go4retro/VIC-MIDI/doc/cFxUoKs.png

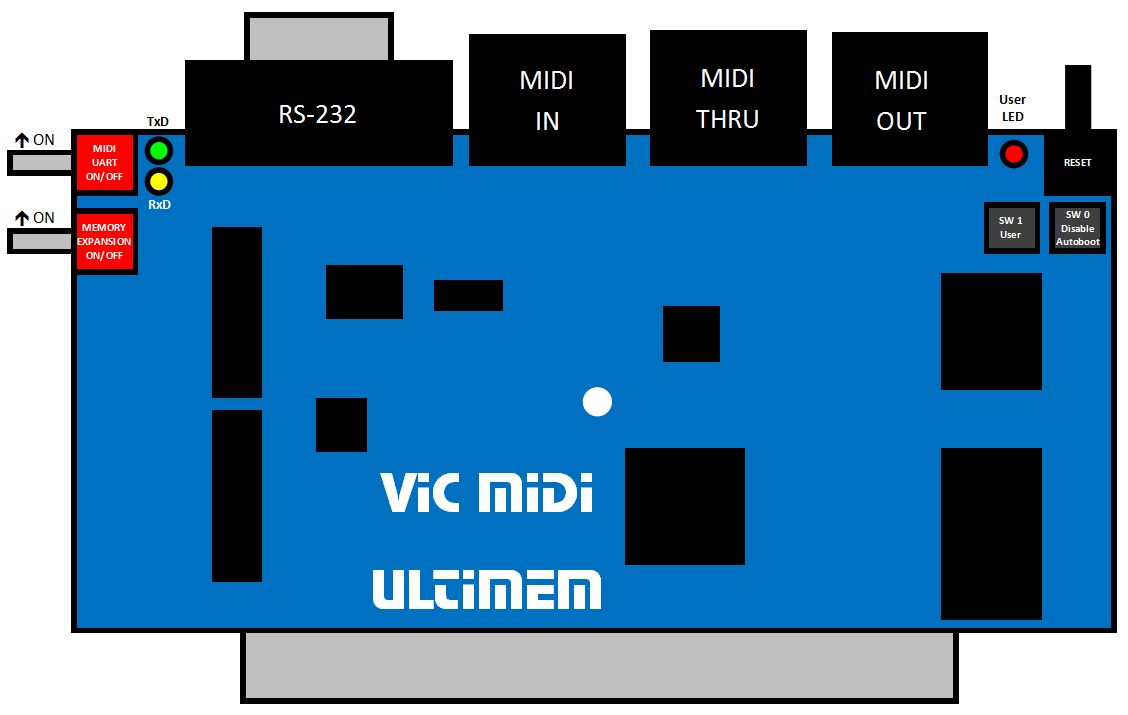
doc/cFxUoKs.png
