go4retro/VIC-MIDI/pcb/VIC-MIDI Final (no pour).png

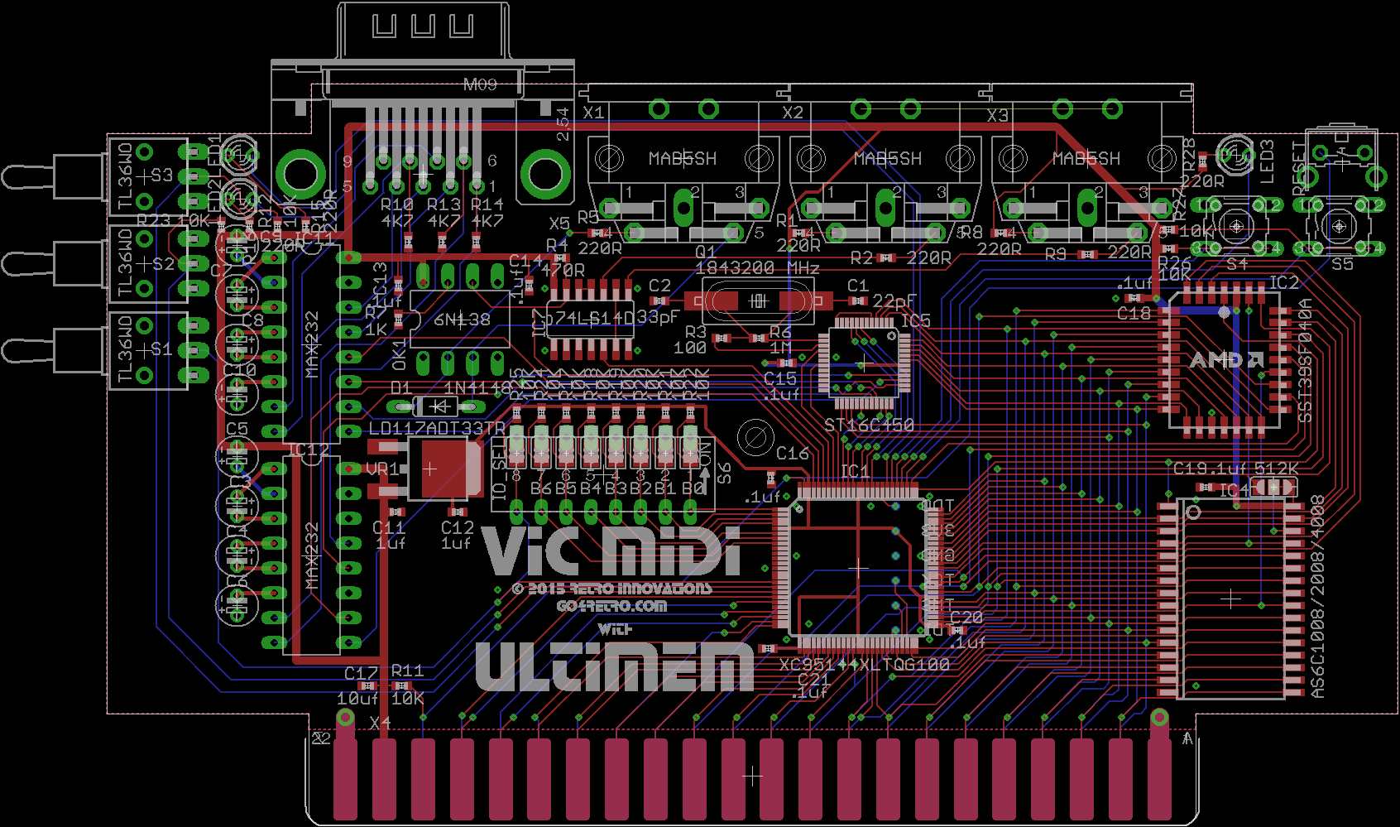
pcb/VIC-MIDI Final (no pour).png
