go4retro/VIC-MIDI/pcb/VIC-MIDI Schematic.png

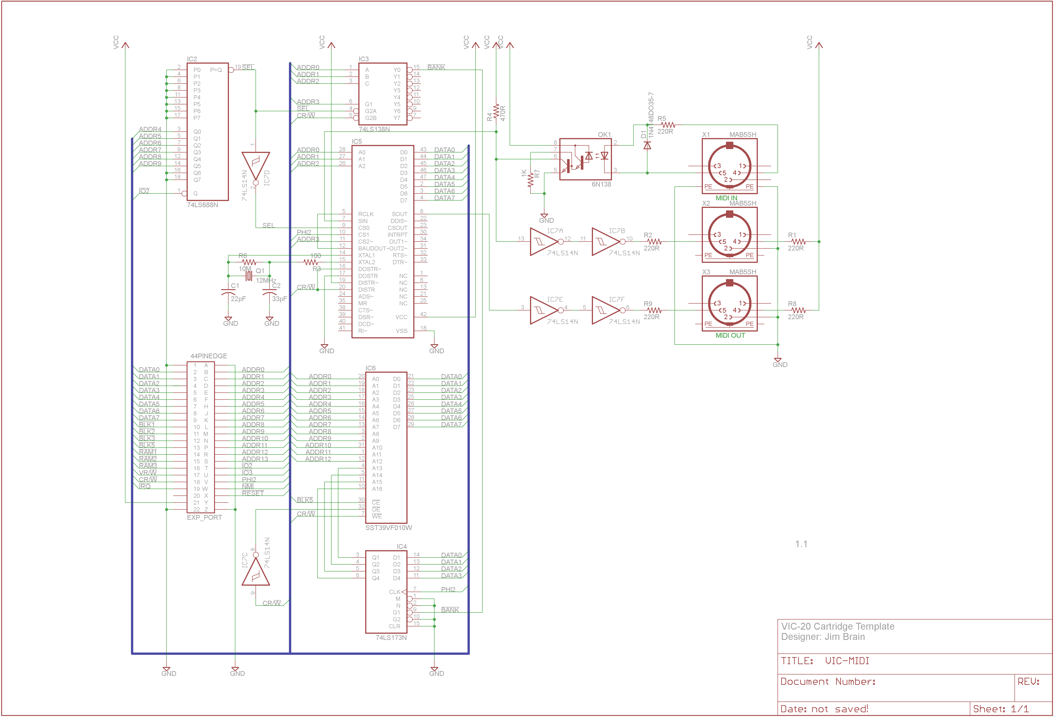
pcb/VIC-MIDI Schematic.png
