go4retro/VIC-MIDI/pcb/VIC-MIDI v0.9 Schematic.png

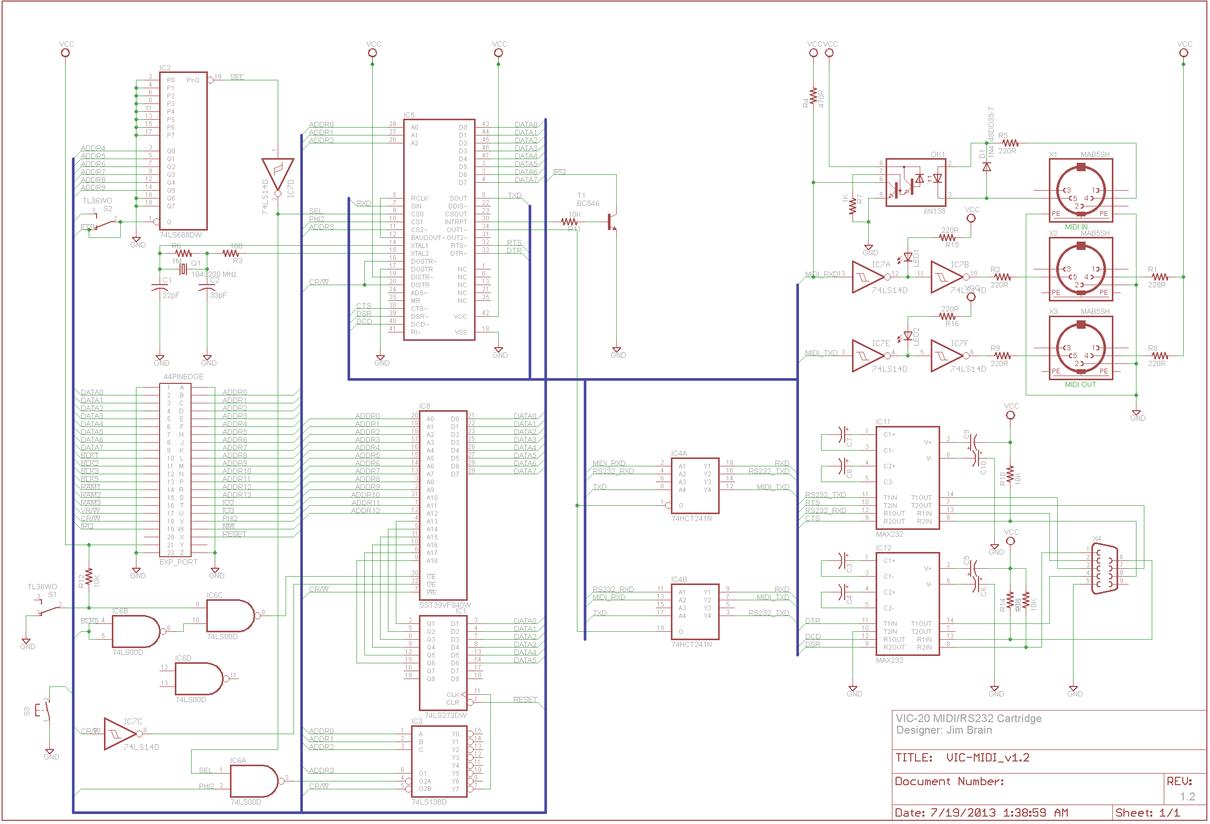
pcb/VIC-MIDI v0.9 Schematic.png
