go4retro/VIC-MIDI/pcb/VIC-MIDI_v1.0b_BOM_np.xlsx

 | Legend | Quantity | Value | Part Number
UltiMem
 | VR1 | 1 | 3.3V LDO VR | LD117ADT33TR
 | IC2 | 1 | 512kBx8 ROM | AM29F040B
 | IC1 | 1 | XC95144XLTQ100 | XC95144XL-TQ100
 | IC3 | 1 | 128kBx8 RAM | KM68100BLG-7L
 | C11,C12 | 1 | 1uf | C-USC0402
 | C17 | 2 | 10uf | C-USC0402
 | C13,C14,C15,C16,C18,C19,C20,C21 | 8 | .1uf | C-USC0402
 | RESET | 1 |  | 31-XX
 | S1,S2 | 2 | TL36WO | TL36WO
 | S4,S5 | 2
 | IC5 | 1 | ST16C450 | XR-16C450Q
 | Q1 | 1 | 1843200 MHz | CRYSTALHC49UP
 | LED1 | 1 | red | LED3MM
 | LED2 | 1 | yellow | LED3MM
 | LED3 | 1 | green | LED3MM
 | C1 | 1 | 22pF | C-USC0402
 | C2 | 1 | 33pF | C-USC0402
 | R3 | 1 | 100 | R-US_R0402
 | R6 | 1 | 1M | R-US_R0402
 | R15,R16,R28 | 3 | 220R | R-US_R0402
 | R11,R12,R17-R25 | 11 | 10K | R-US_R0402
MIDI
 | D1 | 1 | 1N4148 | 1N4148DO35-7
 | IC7 | 1 | 74HCT14 | 74HCT14
 | OK1 | 1 | 6N138 | 6N138
 | X1-X3 | 3 | DIN5 | SDS-50J (http://www.digikey.com/product-detail/en/SDS-50J/CP-2350-ND/97033)
 | R1,R2,R5,R8,R9 | 5 | 220R | R-US_R0402
 | R4 | 1 | 470R | R-US_R0402
 | R7 | 1 | 1K | R-US_R0402
RS232
 | IC11,IC12 | 2 | MAX232 | MAX232
 | C3-C10 | 8 | 1uF | CPOL-USE2-4
 | X4 | 1 | DE-9 M | 1-1634580-2 (http://www.digikey.com/product-detail/en/1-1634580-2/A109020-ND/4031352)
 | R10,R13,R14 | 3 | 4K7 | R-US_R0402
