go4retro/VIC-MIDI/pcb/VIC-MIDI_v1.0b.brd

## EAGLE design pcb/VIC-MIDI_v1.0b.brd (2018-05-06)

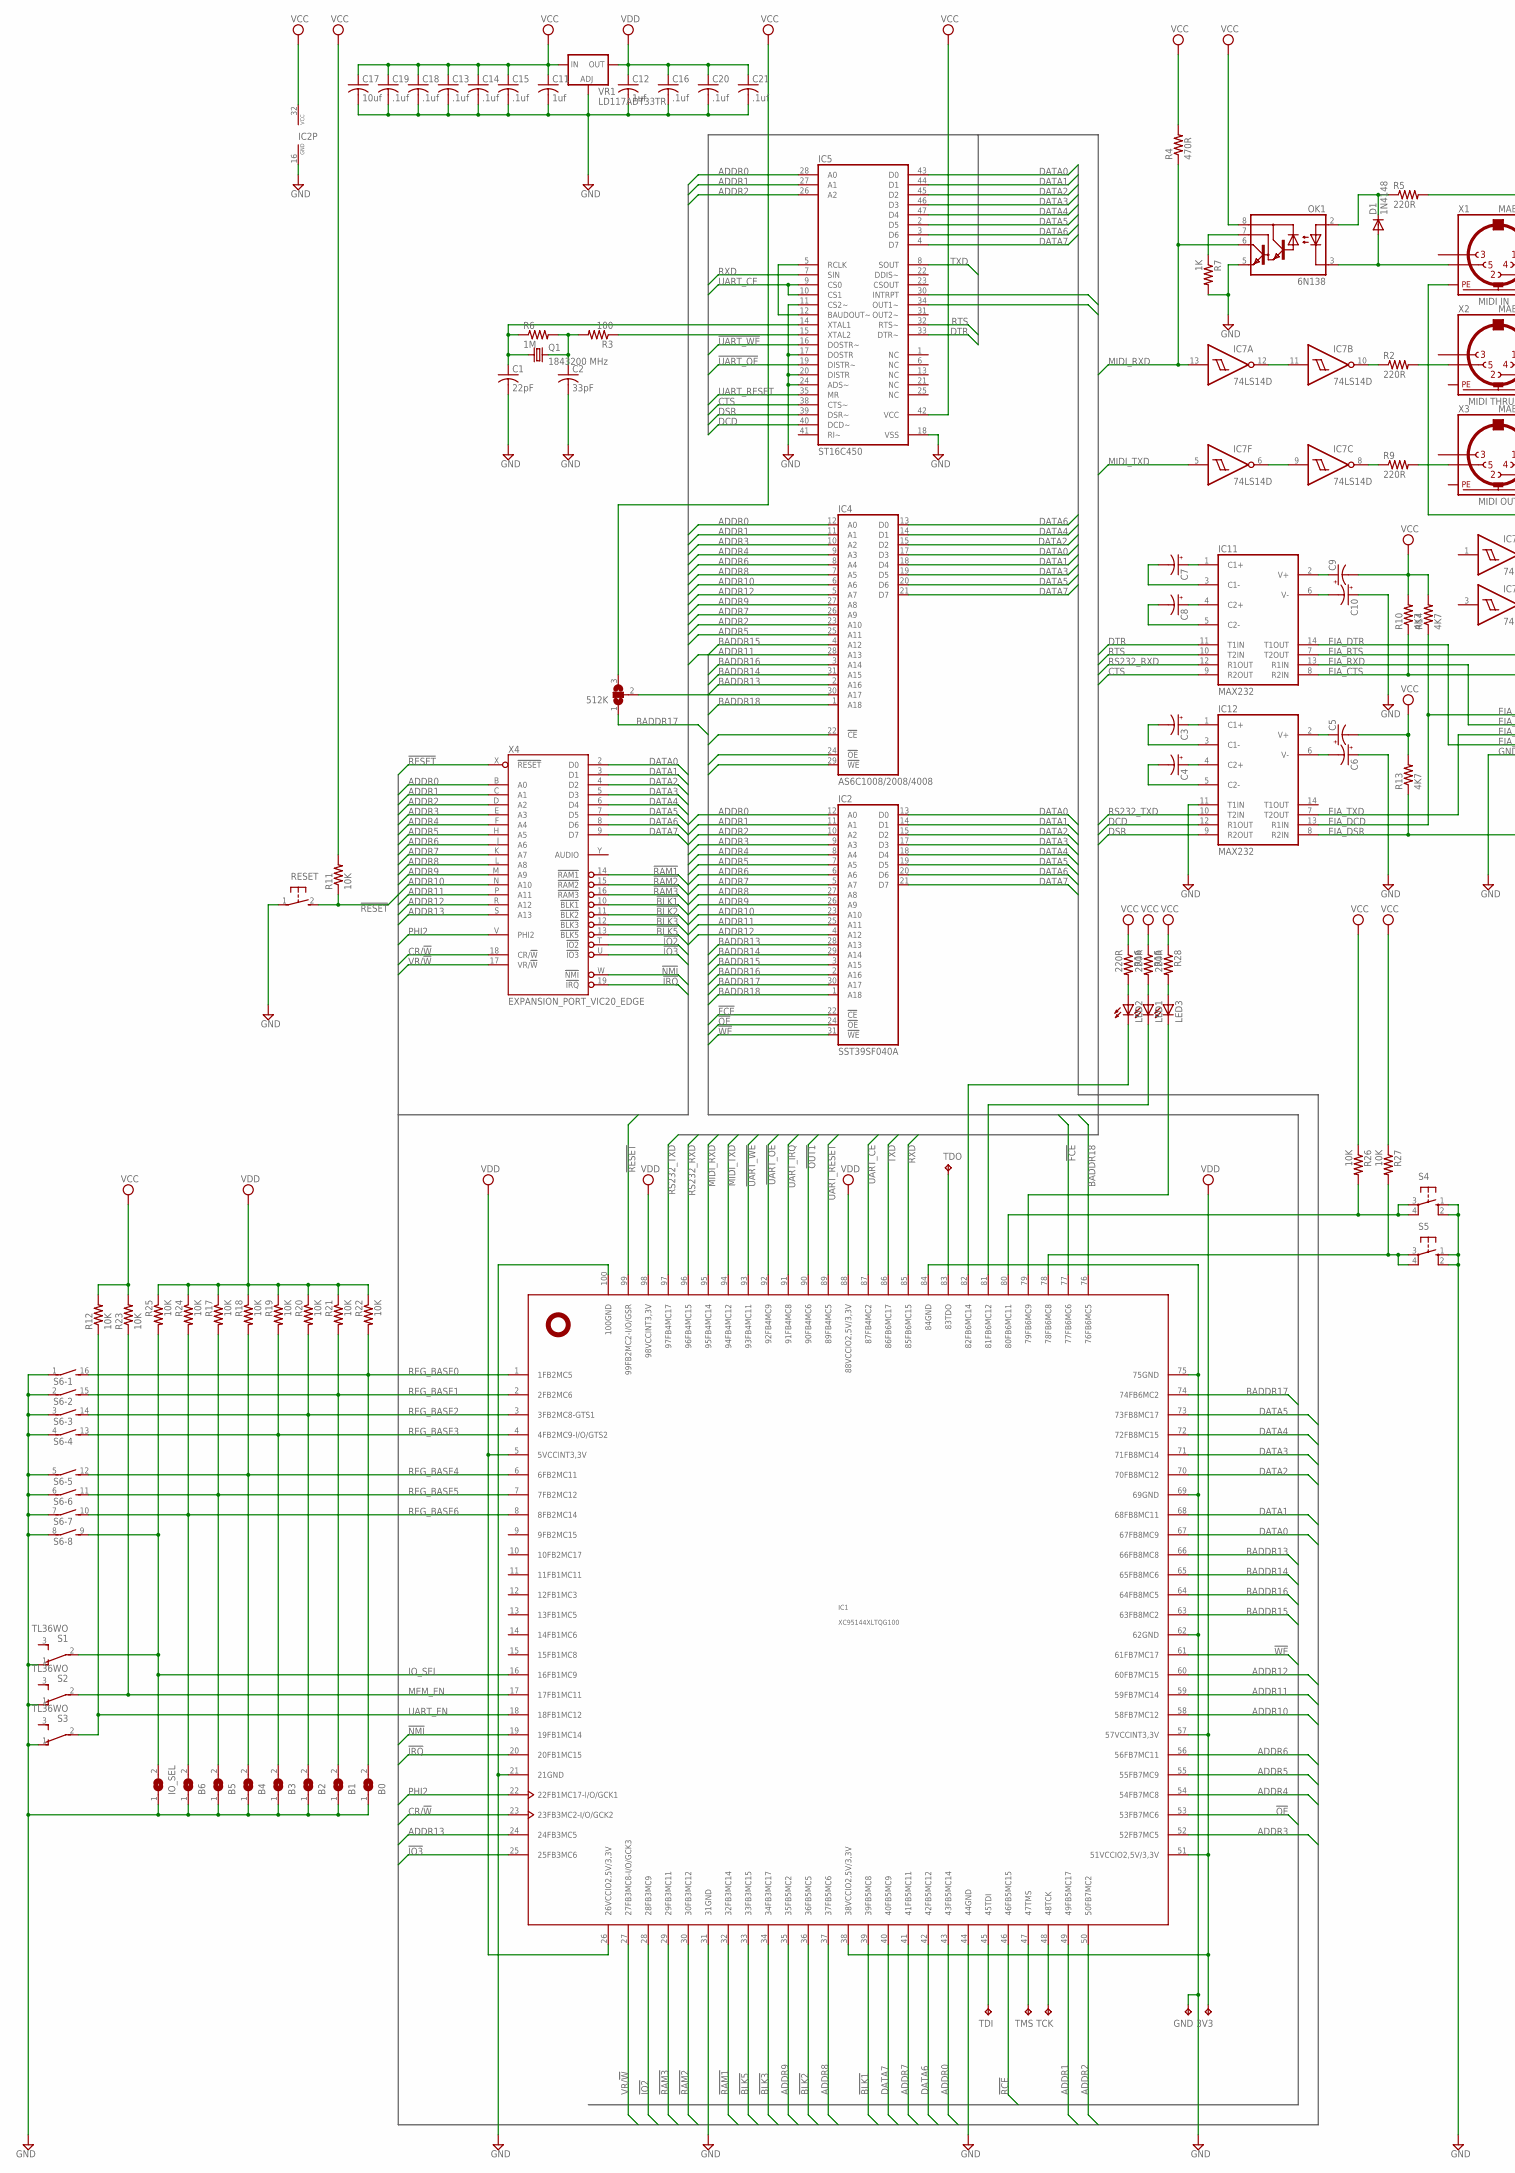
[picture p8: schematic VIC-MIDI_v1.0b.sch, part in row 1, column 1]

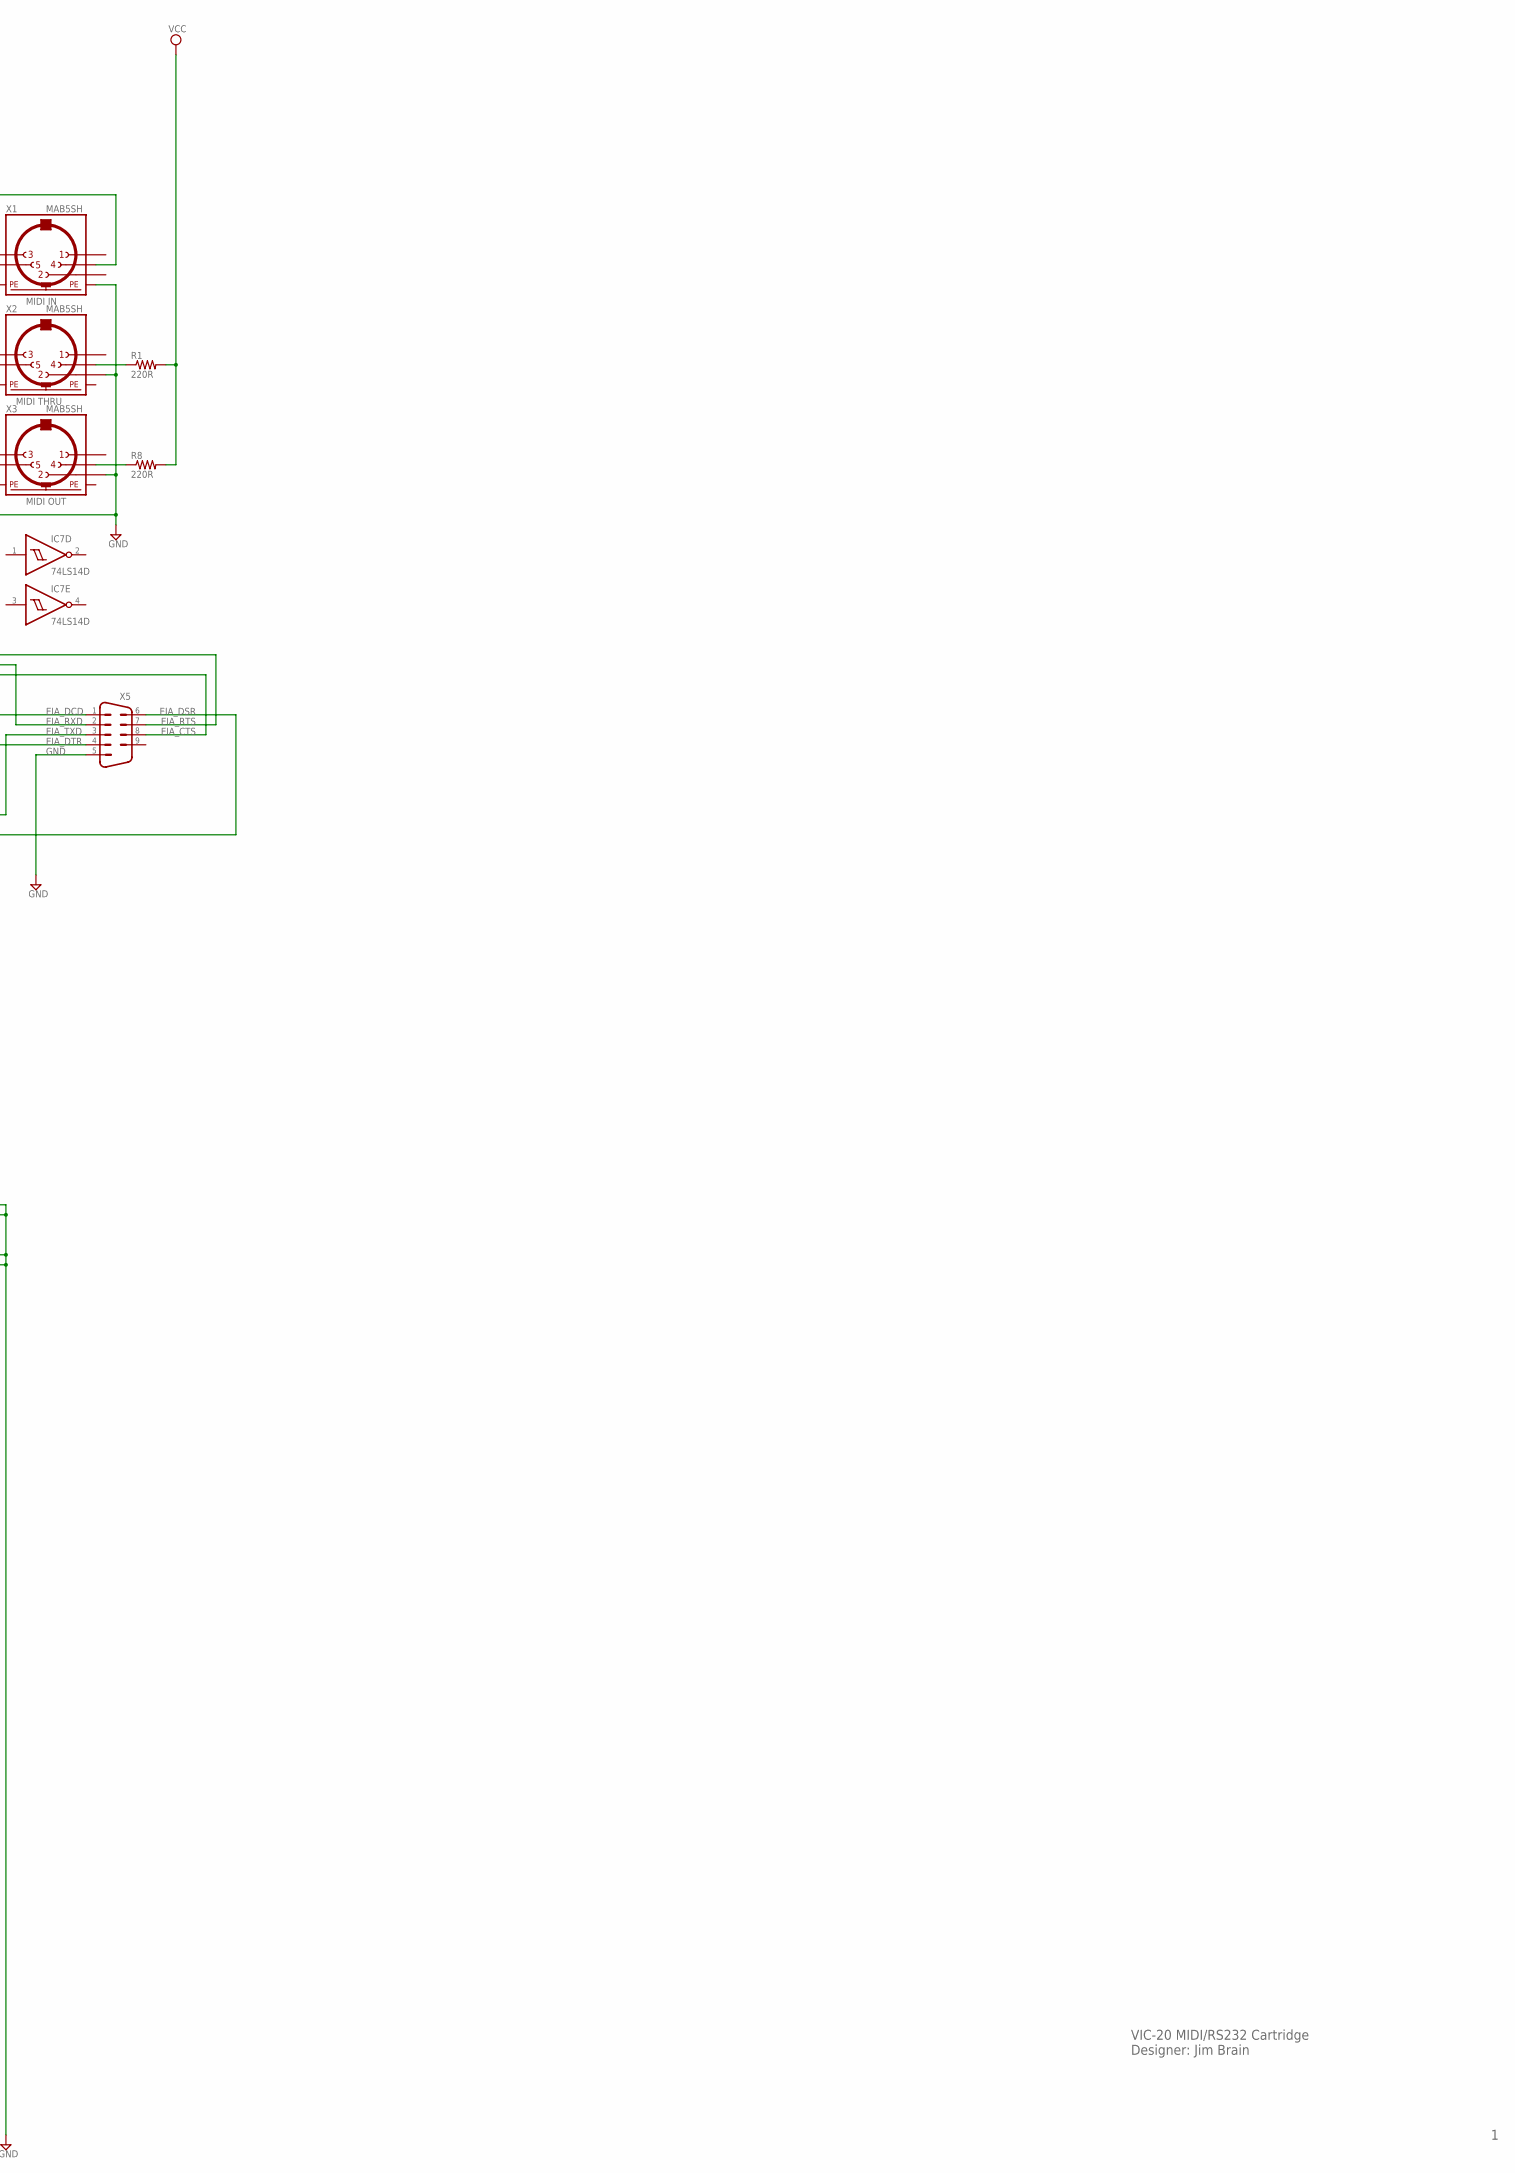
[picture p9: schematic VIC-MIDI_v1.0b.sch, part in row 1, column 2]

Parts:
3V3: TPTP08R; TP08R
512K: SJ2W; SJ_2
B0, B1, B2, B3, B4, B5, B6: SJ
C1: 22pF; C0402
C2: 33pF; C0402
C3, C4, C5, C6, C7, C8, C9, C10: CPOL-USE2-4; E2-4
C11, C12: 1uf; C0402
C13, C14, C15, C16, C18, C19, C20, C21: .1uf; C0402
C17: 10uf; C0402
D1: 1N4148; DO35-7
GND: TPTP08R; TP08R
IC1: XC95144XLTQG100; TQFP100
IC2: SST39SF040A; PLCC32R
IC4: AS6C1008/2008/4008; SOP32L
IC5: ST16C450; TQFP48
IC7: 74LS14D; SO14
IC11, IC12: MAX232; DIL16
IO_SEL: SJ
LED1, LED2, LED3: LED3MM
OK1: 6N138; DIL08
Q1: 1843200 MHz; HC49UP
R1, R2, R5, R8, R9, R15, R16, R28: 220R; R0402
R3: 100; R0402
R4: 470R; R0402
R6: 1M; R0402
R7: 1K; R0402
R10, R13, R14: 4K7; R0402
R11, R12, R17, R18, R19, R20, R21, R22, R23, R24, R25, R26, R27: 10K; R0402
RESET: 31-XX; B3F-31XX
S1, S2, S3: TL36WO; TL3XWO
S4, S5: 10-XX; B3F-10XX
S6: DIP08SB
TCK: TPTP08R; TP08R
TDI: TPTP08R; TP08R
TDO: TPTP08R; TP08R
TMS: TPTP08R; TP08R
VR1: LD117ADT33TR; DPACK
X1, X2, X3: MAB5SH
X4: EXPANSION_PORT_VIC20_EDGE; MA156-22-2
X5: M09HP

Connections:
!BLK1: IC1.39 (39FB5MC8), X4.10 (!BLK1)
!BLK2: IC1.36 (36FB5MC5), X4.11 (!BLK2)
!BLK3: IC1.34 (34FB3MC17), X4.12 (!BLK3)
!BLK5: IC1.33 (33FB3MC15), X4.13 (!BLK5)
!FCE: IC1.77 (77FB6MC6), IC2.22 (!CE)
!IO2: IC1.28 (28FB3MC9), X4.T (!IO2)
!IO3: IC1.25 (25FB3MC6), X4.U (!IO3)
!IRQ: IC1.20 (20FB1MC15), X4.19 (!IRQ)
!NMI: IC1.19 (19FB1MC14), X4.W (!NMI)
!OE: IC1.53 (53FB7MC6), IC2.24 (!OE), IC4.24 (!OE)
!OUT1: IC1.90 (90FB4MC6), IC5.34 (OUT1~)
!RAM1: IC1.32 (32FB3MC14), X4.14 (!RAM1)
!RAM2: IC1.30 (30FB3MC12), X4.15 (!RAM2)
!RAM3: IC1.29 (29FB3MC11), X4.16 (!RAM3)
!RCE: IC1.46 (46FB5MC15), IC4.22 (!CE)
!RESET: IC1.99 (99FB2MC2-I/O/GSR), R11.1, RESET.2 (S), X4.X (!RESET)
!UART_OE: IC1.92 (92FB4MC9), IC5.19 (DISTR~)
!UART_WE: IC1.93 (93FB4MC11), IC5.16 (DOSTR~)
!WE: IC1.61 (61FB7MC17), IC2.31 (!WE), IC4.29 (!WE)
ADDR0: IC1.43 (43FB5MC14), IC2.12 (A0), IC4.12 (A0), IC5.28 (A0), X4.B (A0)
ADDR1: IC1.49 (49FB5MC17), IC2.11 (A1), IC4.11 (A1), IC5.27 (A1), X4.C (A1)
ADDR2: IC1.50 (50FB7MC2), IC2.10 (A2), IC4.23 (A10), IC5.26 (A2), X4.D (A2)
ADDR3: IC1.52 (52FB7MC5), IC2.9 (A3), IC4.10 (A2), X4.E (A3)
ADDR4: IC1.54 (54FB7MC8), IC2.8 (A4), IC4.9 (A3), X4.F (A4)
ADDR5: IC1.55 (55FB7MC9), IC2.7 (A5), IC4.25 (A11), X4.H (A5)
ADDR6: IC1.56 (56FB7MC11), IC2.6 (A6), IC4.8 (A4), X4.J (A6)
ADDR7: IC1.41 (41FB5MC11), IC2.5 (A7), IC4.26 (A9), X4.K (A7)
ADDR8: IC1.37 (37FB5MC6), IC2.27 (A8), IC4.7 (A5), X4.L (A8)
ADDR9: IC1.35 (35FB5MC2), IC2.26 (A9), IC4.27 (A8), X4.M (A9)
ADDR10: IC1.58 (58FB7MC12), IC2.23 (A10), IC4.6 (A6), X4.N (A10)
ADDR11: IC1.59 (59FB7MC14), IC2.25 (A11), IC4.28 (A13), X4.P (A11)
ADDR12: IC1.60 (60FB7MC15), IC2.4 (A12), IC4.5 (A7), X4.R (A12)
ADDR13: IC1.24 (24FB3MC5), X4.S (A13)
BADDR13: IC1.66 (66FB8MC8), IC2.28 (A13), IC4.2 (A16)
BADDR14: IC1.65 (65FB8MC6), IC2.29 (A14), IC4.31 (A15)
BADDR15: IC1.63 (63FB8MC2), IC2.3 (A15), IC4.4 (A12)
BADDR16: IC1.64 (64FB8MC5), IC2.2 (A16), IC4.3 (A14)
BADDR17: 512K.1, IC1.74 (74FB6MC2), IC2.30 (A17)
BADDR18: IC1.76 (76FB6MC5), IC2.1 (A18), IC4.1 (A18)
CR/!W: IC1.23 (23FB3MC2-I/O/GCK2), X4.18 (CR/!W)
CTS: IC5.38 (CTS~), IC11.9 (R2OUT)
DATA0: IC1.67 (67FB8MC9), IC2.13 (D0), IC4.17 (D3), IC5.43 (D0), X4.2 (D0)
DATA1: IC1.68 (68FB8MC11), IC2.14 (D1), IC4.18 (D4), IC5.44 (D1), X4.3 (D1)
DATA2: IC1.70 (70FB8MC12), IC2.15 (D2), IC4.15 (D2), IC5.45 (D2), X4.4 (D2)
DATA3: IC1.71 (71FB8MC14), IC2.17 (D3), IC4.19 (D5), IC5.46 (D3), X4.5 (D3)
DATA4: IC1.72 (72FB8MC15), IC2.18 (D4), IC4.14 (D1), IC5.47 (D4), X4.6 (D4)
DATA5: IC1.73 (73FB8MC17), IC2.19 (D5), IC4.20 (D6), IC5.2 (D5), X4.7 (D5)
DATA6: IC1.42 (42FB5MC12), IC2.20 (D6), IC4.13 (D0), IC5.3 (D6), X4.8 (D6)
DATA7: IC1.40 (40FB5MC9), IC2.21 (D7), IC4.21 (D7), IC5.4 (D7), X4.9 (D7)
DCD: IC5.40 (DCD~), IC12.12 (R1OUT)
DSR: IC5.39 (DSR~), IC12.9 (R2OUT)
DTR: IC5.33 (DTR~), IC11.11 (T1IN)
EIA_CTS: IC11.8 (R2IN), R10.1, X5.8
EIA_DCD: IC12.13 (R1IN), R14.1, X5.1
EIA_DSR: IC12.8 (R2IN), R13.1, X5.6
EIA_DTR: IC11.14 (T1OUT), X5.4
EIA_RTS: IC11.7 (T2OUT), X5.7
EIA_RXD: IC11.13 (R1IN), X5.2
EIA_TXD: IC12.7 (T2OUT), X5.3
GND: B0.1, B1.1, B2.1, B3.1, B4.1, B5.1, B6.1, C1.2, C2.2, C6.+, C10.+, C11.2, C12.2, C13.2, C14.2, C15.2, C16.2, C17.2, C18.2, C19.2, C20.2, C21.2, GND.TP, IC1.21 (21GND), IC1.31 (31GND), IC1.44 (44GND), IC1.62 (62GND), IC1.69 (69GND), IC1.75 (75GND), IC1.84 (84GND), IC1.100 (100GND), IC2.16 (GND), IC4.16 (GND), IC5.11 (CS2~), IC5.17 (DOSTR), IC5.18 (VSS), IC5.20 (DISTR), IC5.24 (ADS~), IC7.7 (GND), IC11.15 (GND), IC12.11 (T1IN), IC12.15 (GND), IO_SEL.1, OK1.5 (GND), R7.2, RESET.1, S1.1 (O), S2.1 (O), S3.1 (O), S4.1 (S), S4.2 (S1), S5.1 (S), S5.2 (S1), S6.1, S6.2 (1), S6.3 (1), S6.4 (1), S6.5 (1), S6.6 (1), S6.7 (1), S6.8 (1), VR1.1 (ADJ), X1.PE, X1.PE@ (PE), X2.2, X3.2, X4.1 (GND), X4.22 (GND), X4.A (GND), X4.Z (GND), X5.5
IO_SEL: IC1.16 (16FB1MC9), IO_SEL.2, R25.2, S1.2, S6.9 (2)
MEM_EN: IC1.17 (17FB1MC11), R23.1, S2.2
MIDI_RXD: IC1.95 (95FB4MC14), IC7.13 (I), OK1.6 (VO), R4.1
MIDI_TXD: IC1.94 (94FB4MC12), IC7.5 (I)
unnamed: R9.2, X3.5
unnamed: IC7.6 (O), IC7.9 (I)
unnamed: R8.1, X3.4
unnamed: IC7.8 (O), R9.1
unnamed: LED1.A, R15.2
unnamed: D1.C, OK1.2 (A), R5.1
unnamed: R5.2, X1.4
unnamed: D1.A, OK1.3 (C), X1.5
unnamed: OK1.7 (VB), R7.1
unnamed: R2.2, X2.5
unnamed: IC7.10 (O), R2.1
unnamed: IC7.11 (I), IC7.12 (O)
unnamed: R1.1, X2.4
unnamed: IC1.78 (78FB6MC8), R27.2, S5.3, S5.4 (P1)
unnamed: IC5.15 (XTAL2), R3.1
unnamed: C1.1, IC5.14 (XTAL1), Q1.1, R6.1
unnamed: C2.1, Q1.2, R3.2, R6.2
unnamed: IC1.81 (81FB6MC12), LED1.K (C)
unnamed: IC5.5 (RCLK), IC5.12 (BAUDOUT~)
unnamed: IC1.80 (80FB6MC11), R26.2, S4.3, S4.4 (P1)
unnamed: IC1.82 (82FB6MC14), LED2.K (C)
unnamed: LED3.A, R28.2
unnamed: IC1.79 (79FB6MC9), LED3.K (C)
unnamed: LED2.A, R16.2
unnamed: IC1.48 (48TCK), TCK.TP
unnamed: IC1.47 (47TMS), TMS.TP
unnamed: IC1.45 (45TDI), TDI.TP
unnamed: IC1.83 (83TDO), TDO.TP
unnamed: C3.+, IC12.1 (C1+)
unnamed: C3.-, IC12.3 (C1-)
unnamed: C4.+, IC12.4 (C2+)
unnamed: C4.-, IC12.5 (C2-)
unnamed: C5.+, IC12.2 (V+)
unnamed: C6.-, IC12.6 (V-)
unnamed: C7.+, IC11.1 (C1+)
unnamed: C7.-, IC11.3 (C1-)
unnamed: C8.+, IC11.4 (C2+)
unnamed: C8.-, IC11.5 (C2-)
unnamed: C9.+, IC11.2 (V+)
unnamed: C10.-, IC11.6 (V-)
unnamed: 512K.2, IC4.30 (A17)
PE: X2.PE, X2.PE@ (PE), X3.PE, X3.PE@ (PE)
PHI2: IC1.22 (22FB1MC17-I/O/GCK1), X4.V (PHI2)
REG_BASE0: B0.2, IC1.1 (1FB2MC5), R22.2, S6.16 (2)
REG_BASE1: B1.2, IC1.2 (2FB2MC6), R21.2, S6.15 (2)
REG_BASE2: B2.2, IC1.3 (3FB2MC8-GTS1), R20.2, S6.14 (2)
REG_BASE3: B3.2, IC1.4 (4FB2MC9-I/O/GTS2), R19.2, S6.13 (2)
REG_BASE4: B4.2, IC1.6 (6FB2MC11), R18.2, S6.12 (2)
REG_BASE5: B5.2, IC1.7 (7FB2MC12), R17.2, S6.11 (2)
REG_BASE6: B6.2, IC1.8 (8FB2MC14), R24.2, S6.10 (2)
RS232_RXD: IC1.96 (96FB4MC15), IC11.12 (R1OUT)
RS232_TXD: IC1.97 (97FB4MC17), IC12.10 (T2IN)
RTS: IC5.32 (RTS~), IC11.10 (T2IN)
RXD: IC1.85 (85FB6MC15), IC5.7 (SIN)
TXD: IC1.86 (86FB6MC17), IC5.8 (SOUT)
UART_CE: IC1.87 (87FB4MC2), IC5.9 (CS0), IC5.10 (CS1)
UART_EN: IC1.18 (18FB1MC12), R12.1, S3.2
UART_IRQ: IC1.91 (91FB4MC8), IC5.30 (INTRPT)
UART_RESET: IC1.89 (89FB4MC5), IC5.35 (MR)
VCC: 512K.3, C5.-, C9.-, C11.1, C13.1, C14.1, C15.1, C17.1, C18.1, C19.1, IC2.32 (VCC), IC4.32 (VCC), IC5.42 (VCC), IC7.14 (VCC), IC11.16 (VCC), IC12.16 (VCC), OK1.8 (VCC), R1.2, R4.2, R8.2, R10.2, R11.2, R12.2, R13.2, R14.2, R15.1, R16.1, R23.2, R26.1, R27.1, R28.1, VR1.3 (IN), X4.21 (VCC)
VDD: 3V3.TP, C12.1, C16.1, C20.1, C21.1, IC1.5 (5VCCINT3,3V), IC1.26 (26VCCIO2,5V/3,3V), IC1.38 (38VCCIO2,5V/3,3V), IC1.51 (51VCCIO2,5V/3,3V), IC1.57 (57VCCINT3,3V), IC1.88 (88VCCIO2,5V/3,3V), IC1.98 (98VCCINT3,3V), R17.1, R18.1, R19.1, R20.1, R21.1, R22.1, R24.1, R25.1, VR1.4 (OUT)
VR/!W: IC1.27 (27FB3MC8-I/O/GCK3), X4.17 (VR/!W)

Notes on the sheet:
Designer: Jim Brain
VIC-20 MIDI/RS232 Cartridge
MIDI OUT
MIDI IN
MIDI THRU

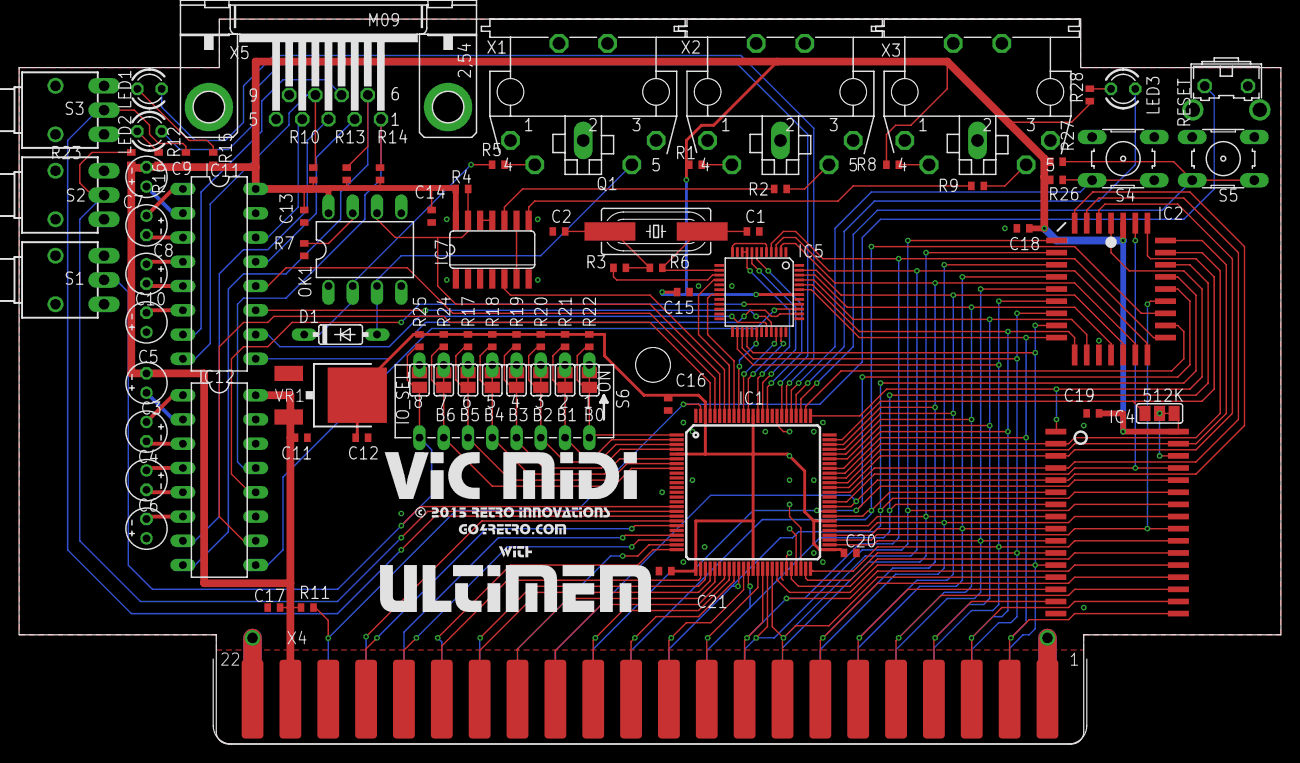
[picture p10: board VIC-MIDI_v1.0b.brd from above]

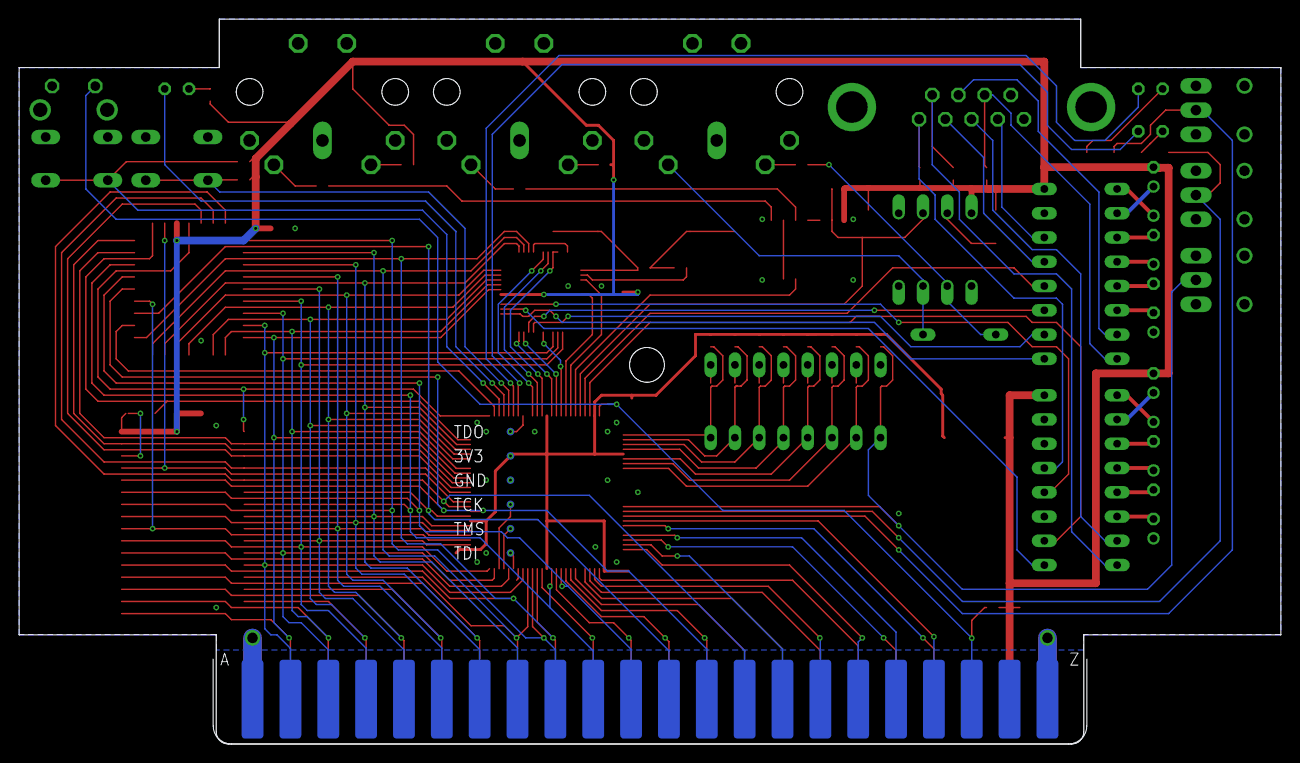
[picture p11: board VIC-MIDI_v1.0b.brd from below]

Board: 2 copper layers, 132.1 x 75.9 mm, 90 parts (6 on the bottom side), 126 nets.
