go4retro/VIC-MIDI/hdl/VICMIDI.v

`timescale 1ns / 1ps
//////////////////////////////////////////////////////////////////////////////////
// Company: 
// Engineer: 
// 
// Create Date:    23:54:21 11/17/2013 
// Design Name: 
// Module Name:    main 
// Project Name: 
// Target Devices: 
// Tool versions: 
// Description: 
//
// Dependencies: 
//
// Revision: 
// Revision 0.01 - File Created
// Additional Comments: 
//
//////////////////////////////////////////////////////////////////////////////////

module vicmidi(
					reset, 
					clock, 
					r_w, 
					address, 
					data, 
					uart_en, 
					mem_en, 
					io, 
					io_sel, 
					flash_ce, 
					ram_ce, 
					we, 
					oe, 
					uart_ce, 
					uart_we, 
					uart_oe, 
					ram1, 
					ram2, 
					ram3, 
					blk1, 
					blk2, 
					blk3, 
					blk5, 
					base, 
					bank, 
					midi_txd, 
					midi_rxd, 
					rs232_txd, 
					rs232_rxd, 
					txd, 
					rxd, 
					rxd_led, 
					txd_led, 
					ser_sel, 
					uart_irq, 
					irq, 
					nmi, 
					uart_reset, 
					act_led, 
					switch
				  );

inout 	reset;
input 	clock;
input 	r_w;
input 	[9:0]address;
inout 	[7:0]data;
input 	uart_en;
input 	mem_en;
input 	[3:2] io;
input 	io_sel;
output 	flash_ce;
output 	ram_ce;
output 	we;
output 	oe;
input 	ram1;
input 	ram2;
input 	ram3;
input 	blk1;
input 	blk2;
input 	blk3;
input 	blk5;
input 	[6:0]base;
output 	[18:13]bank;
output 	act_led;
input 	[1:0]switch;
output  	irq;
output  	nmi;

output 	uart_ce;
output 	uart_oe;
output 	uart_we;

output  	midi_txd;
input   	midi_rxd;
output  	rs232_txd;
input   	rs232_rxd;
input   	txd;
output  	rxd;
output  	rxd_led;
output  	txd_led;
input   	ser_sel;
input   	uart_irq;
output  	uart_reset;

wire 		led;
wire 		[7:0] reg_data;
wire 		reg_data_read;
wire 		reset_out;
wire 		data_read;  // we don't use this...

// assigns
assign io_uart = 						(io_sel ? io[3] : io[2]);

assign midi_txd = 					(ser_sel ? 0 : txd);
assign rs232_txd = 					(ser_sel ? txd : rs232_rxd);
assign rxd = 							(ser_sel ? rs232_rxd : midi_rxd);

assign irq = 							(uart_irq ? 0 : 1'bz);  // negate IRQ from RS232
assign nmi = 							1'bz;
assign uart_reset = 					!reset;
assign uart_ce = 						(clock & !uart_en & !io_uart & (address[9:3] == base[6:0])); // active high
assign uart_oe =                 clock & !r_w;
assign uart_we =                 clock & r_w;
assign rxd_led =                 (!rxd ? 0 : 1'bz);
assign txd_led =                 (!txd ? 0 : 1'bz);
assign act_led =                 (led ? 0 : 1'bz);
assign reset =                	(!reset_out ? 0 : 1'bz);  // reset_out is active low

assign data = 							(reg_data_read ? reg_data : 8'bz);


MemExpander #(.WIDTH(6), .MEMEXPANDER_ID('b00010010))			MemExpander1((!mem_en & !uart_ce),  // on except when uart is accessed.
                                              reset, 
                                              reset_out, 
															 clock, 
															 r_w, 
															 address, 
															 data, 
															 reg_data, 
															 reg_data_read, 
															 io, 
															 flash_ce, 
															 ram_ce, 
															 we, 
															 oe, 
															 ram1, 
															 ram2, 
															 ram3, 
															 blk1, 
															 blk2, 
															 blk3, 
															 blk5, 
															 bank[18:13],
															 led,
															 switch,
															 data_read
															);

endmodule
