go4retro/VIC-MIDI/(commit log)

2018-05-06 Move mapping file to reference
    [UART Mappings.xlsx]
2018-05-06 Shipping Verilog Codebase
    [UART Mappings.xlsx]
